swat98/Save-water/(list of files, drawings)

Other design files:
WATER_LEVEL_2.pdsprj
